WARMW00D/esp32-tcp-com/Main page.png

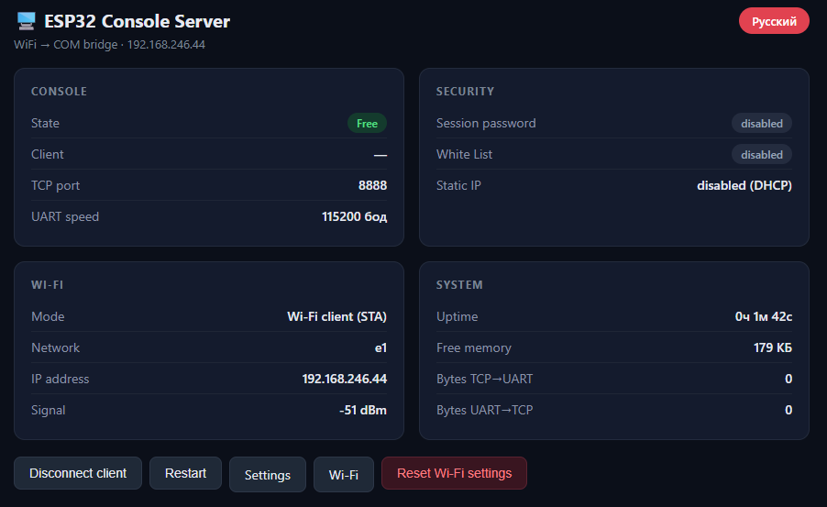
Main page.png
