WARMW00D/esp32-tcp-com/WiFi settings.png

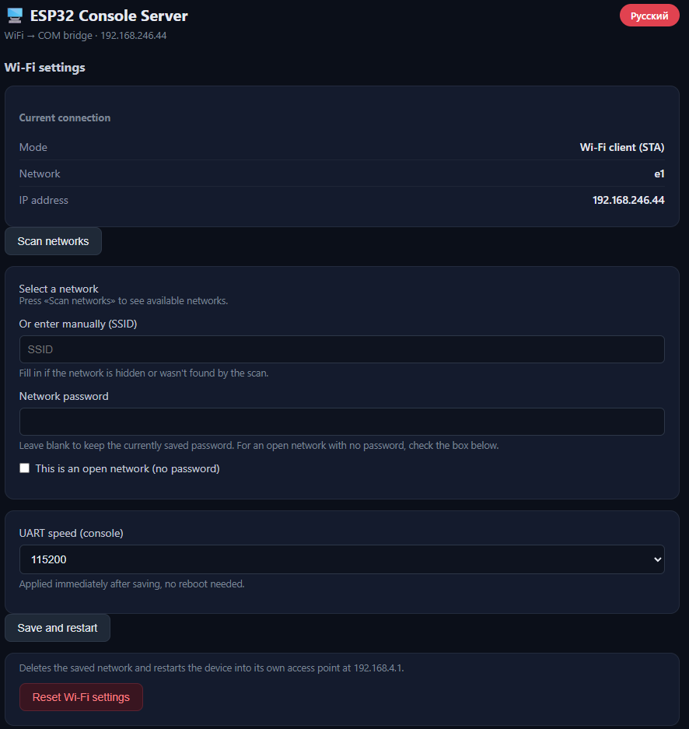
WiFi settings.png
